srnrtkmh/RoomSeeker/README.md

# RoomSeeker
Autonomous robot project in my room
