srnrtkmh/RoomSeeker/HardwareElectric/01_RoomSeeker_SystemConfiguration_210212.pdf

1 | 2 | 3 | 4 | 5 | 6 | 7 | 8 | 9 | 10 | 11 | 12 | 13 | 14 | 15 | 16 | 17 | 18 | 19 | 20 | 21 | 22 | 23 | 24 | 25 | 26 | 27 | 28 | 29 | 30 | 31 | 32
A | A
B | B
C | C
Vcc (3.3V) | USB cable | USB cable
D | Echo | D
| | | | | | Trig
E | Gnd | E

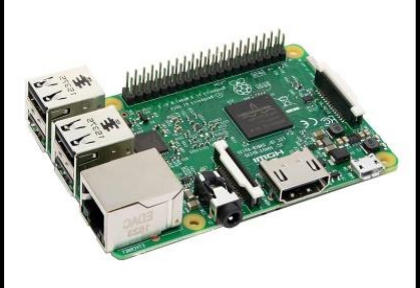
[picture p1: figure]

F | F
G | G
H | H
Vcc (5V)
I | Trig | I
| | | | | | Echo

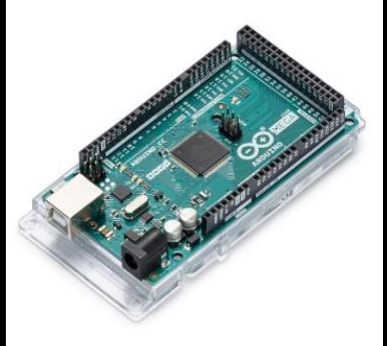
[picture p2: figure]

J | Gnd | USB cable | J
K | K
L | L
M | M
N | Vcc (5V) | N
| | | | | | Gnd
O | Out | O
P | P
Q | Q
R | R
S | Gnd | S
Vcc (5V)
T | Dat | T
| | | | | | Sel
U | Cmd | U
| | | | | | Clk
V | V
W | W
X | X
Y | Y
Z | Update Information | Z
１．'21/2/13 初版完成
２．
３．
４．
Copyright © Kyohei UMEMOTO. All Right Reserved.

## System Configuration of RoomSeeker

USB cable

Designed By | Title: System Configuration of RoomSeeker Kyohei UMEMOTO
Checked By | Doc No. | 20I001 | - | 1 Kyohei UMEMOTO

RPLiDAR A1M8

Arduino
Nano

L298N
Motor
Control
board

Ultra sonic sensor
HC-SR04

IMU unit
MPU-9250

ArduinoMega
with
RoomSeeker
Shield

Ir obstacle sensor
HC-SR04

×4

×12

×1

Wireless PS2
controller

Raspberry Pi 3
Model B

Arduino
Nano

L298N
Motor
Control
board
