srnrtkmh/RoomSeeker/Level2_Remote/room_seeker_description/meshes/sensors/RP-lidar-A1.stl

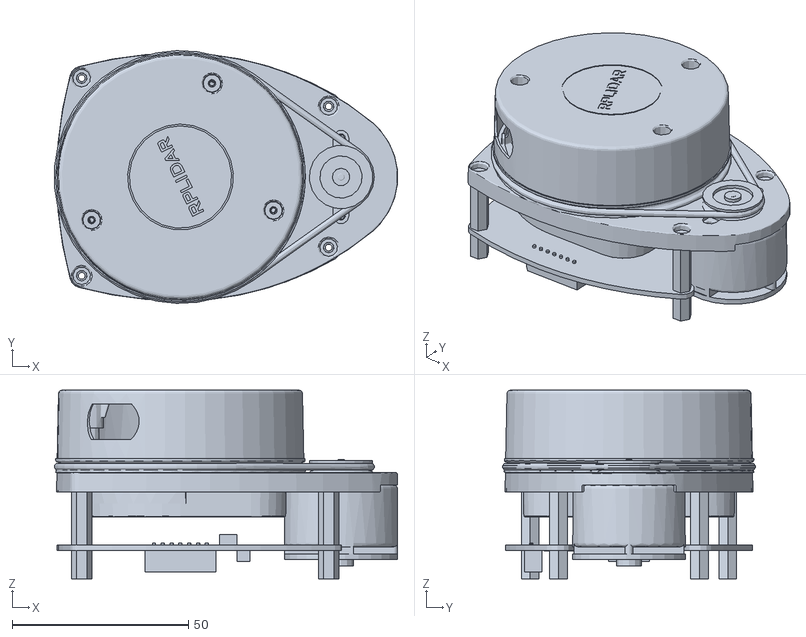
[picture p3: CAD file, 2021-02-12]
Level2_Remote/room_seeker_description/meshes/sensors/RP-lidar-A1.stl
97.2 x 71.6 x 53.5
