srnrtkmh/RoomSeeker/Level2_Remote/room_seeker_description/meshes/wheels/LeftMecanumWheel.stl

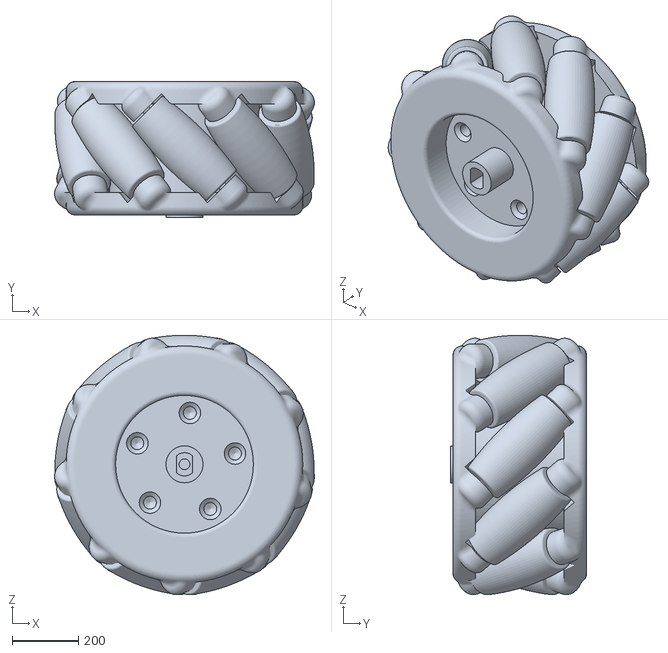
[picture p4: CAD file, 2021-01-31]
Level2_Remote/room_seeker_description/meshes/wheels/LeftMecanumWheel.stl
785.8 x 410.8 x 784.3
