srnrtkmh/RoomSeeker/Level2_Remote/room_seeker_description/meshes/sensors/lds.stl

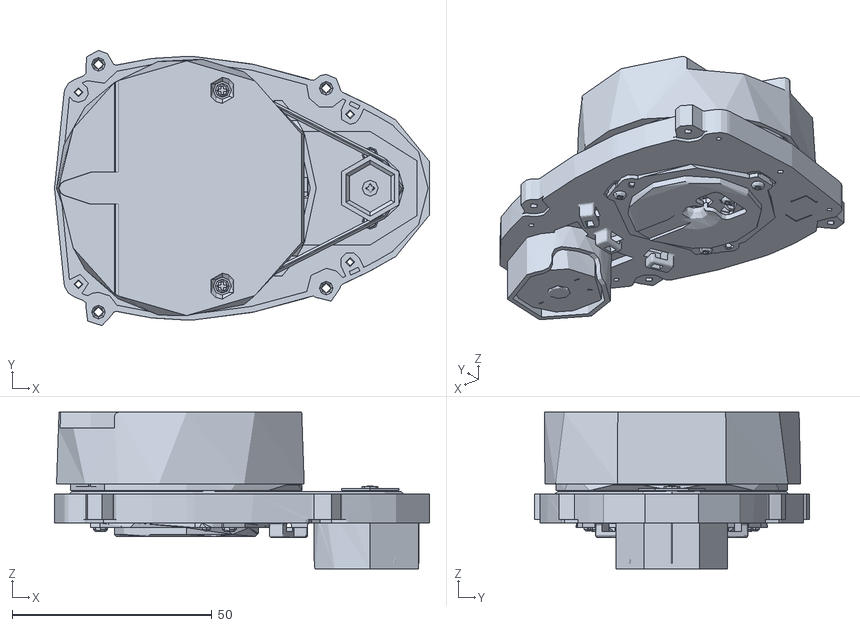
[picture p5: CAD file, 2021-01-28]
Level2_Remote/room_seeker_description/meshes/sensors/lds.stl
93.8 x 68.9 x 39.2
