srnrtkmh/RoomSeeker/Level2_Remote/room_seeker_description/meshes/wheels/RightMecanumWheel.stl

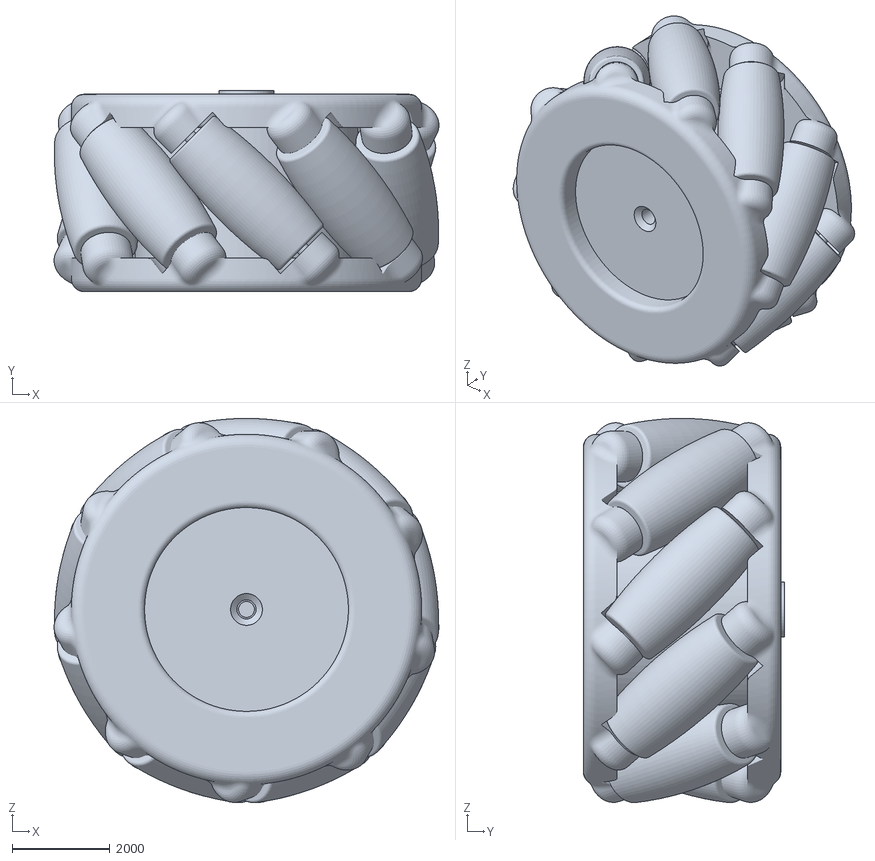
[picture p6: CAD file, 2021-01-31]
Level2_Remote/room_seeker_description/meshes/wheels/RightMecanumWheel.stl
7858.0 x 4108.0 x 7842.6
