srnrtkmh/RoomSeeker/HardwareElectric/02_RoomSeeker_PowerSupplyDIagram_210212.pdf

## Power supply diagram

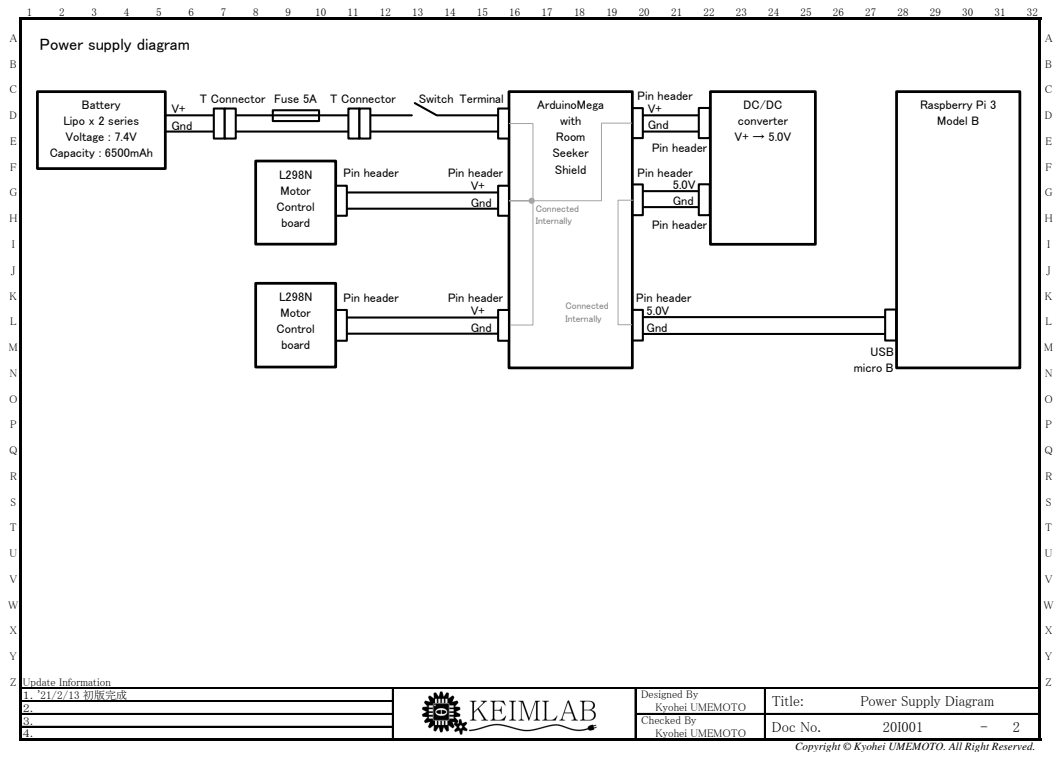
[picture p7: page 1]
Update Information; １．'21/2/13 初版完成 ２． ３． ４．; Checked By; Doc No.; 2 Kyohei UMEMOTO; Designed By; Title:; Power Supply Diagram Kyohei UMEMOTO; 5.0V Gnd; Pin header; USB micro B; V+ Gnd; ArduinoMega with Room Seeker Shield; Raspberry Pi 3 Model B; Battery Lipo x 2 series Voltage : 7.4V Capacity : 6500mAh; T Connector Fuse 5A T Connector; Switch Terminal; L298N Motor Control board; Gnd; DC/DC converter V+ → 5.0V; Connected Internally

Copyright © Kyohei UMEMOTO. All Right Reserved.
