srnrtkmh/RoomSeeker/HardwareElectric/DCMotorController_rev1.pdf

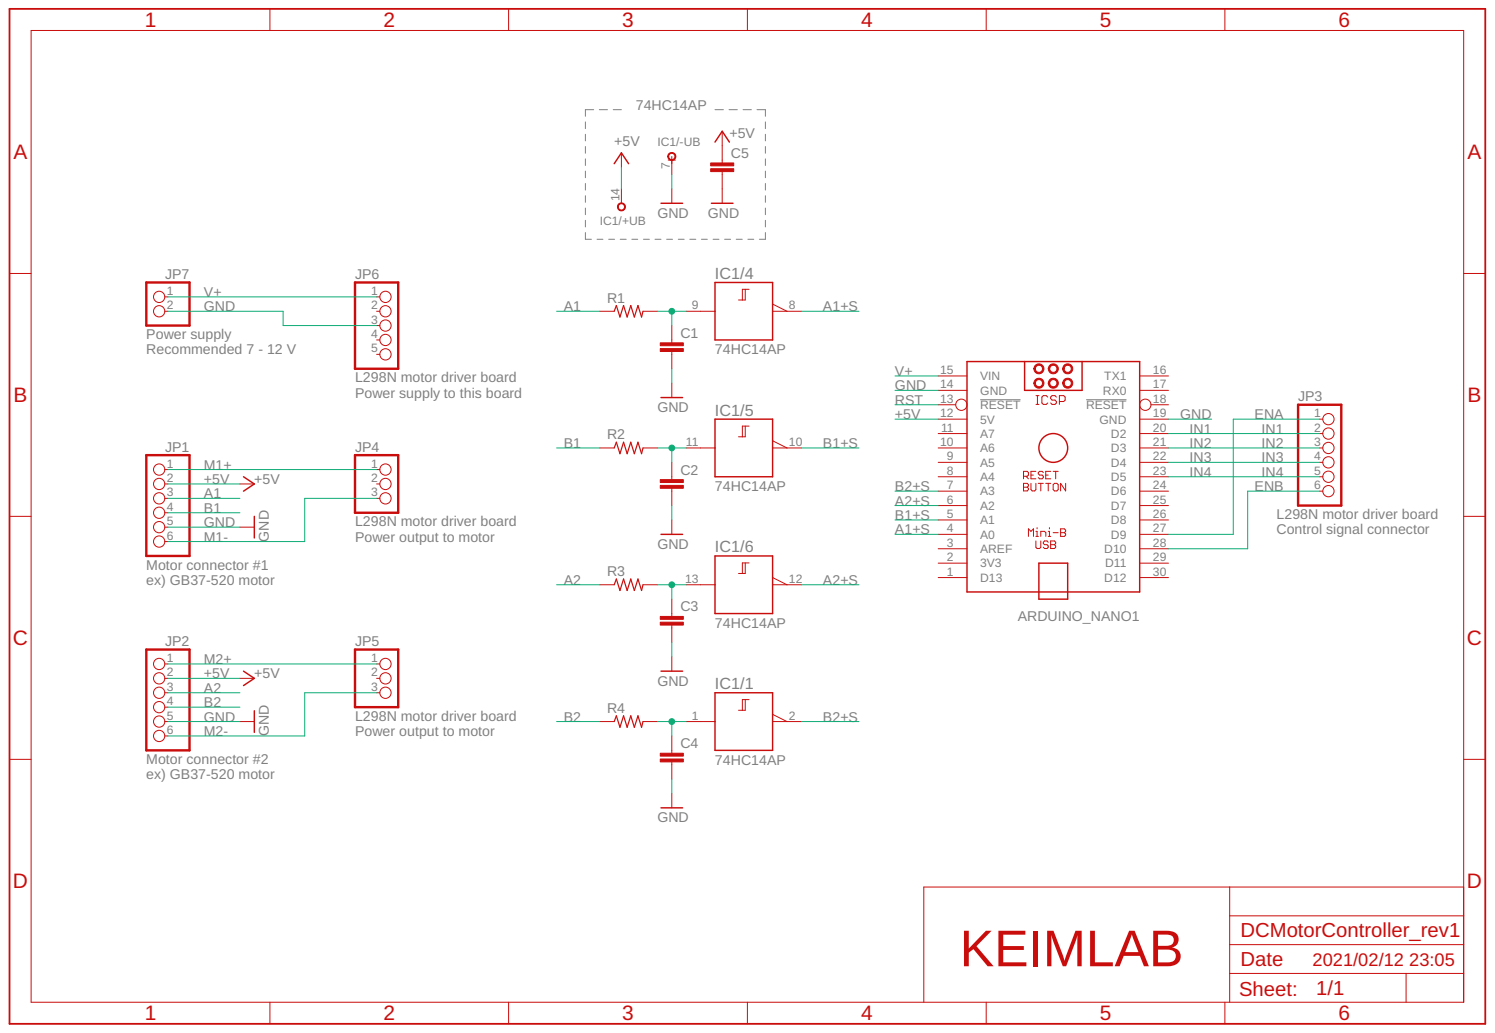
[picture p8: page 1]

L298N motor driver board
Power supply to this board

Control signal connector L298N motor driver board
Power output to motor
