srnrtkmh/RoomSeeker/HardwareElectric/RoomSeekerShield_rev4.pdf

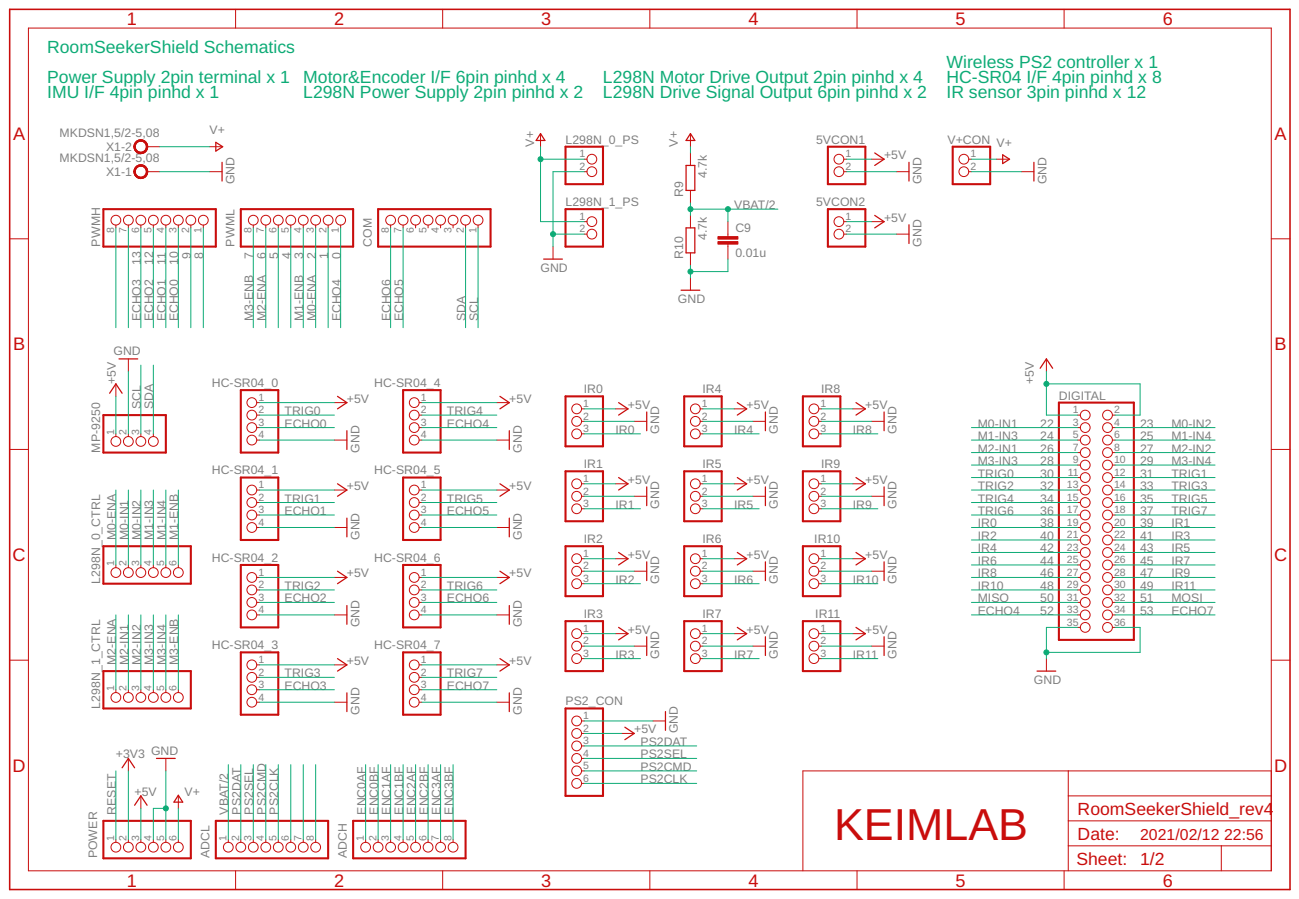
[picture p9: page 1]

L298N Motor Drive Output 2pin pinhd x 4
L298N Drive Signal Output 6pin pinhd x 2

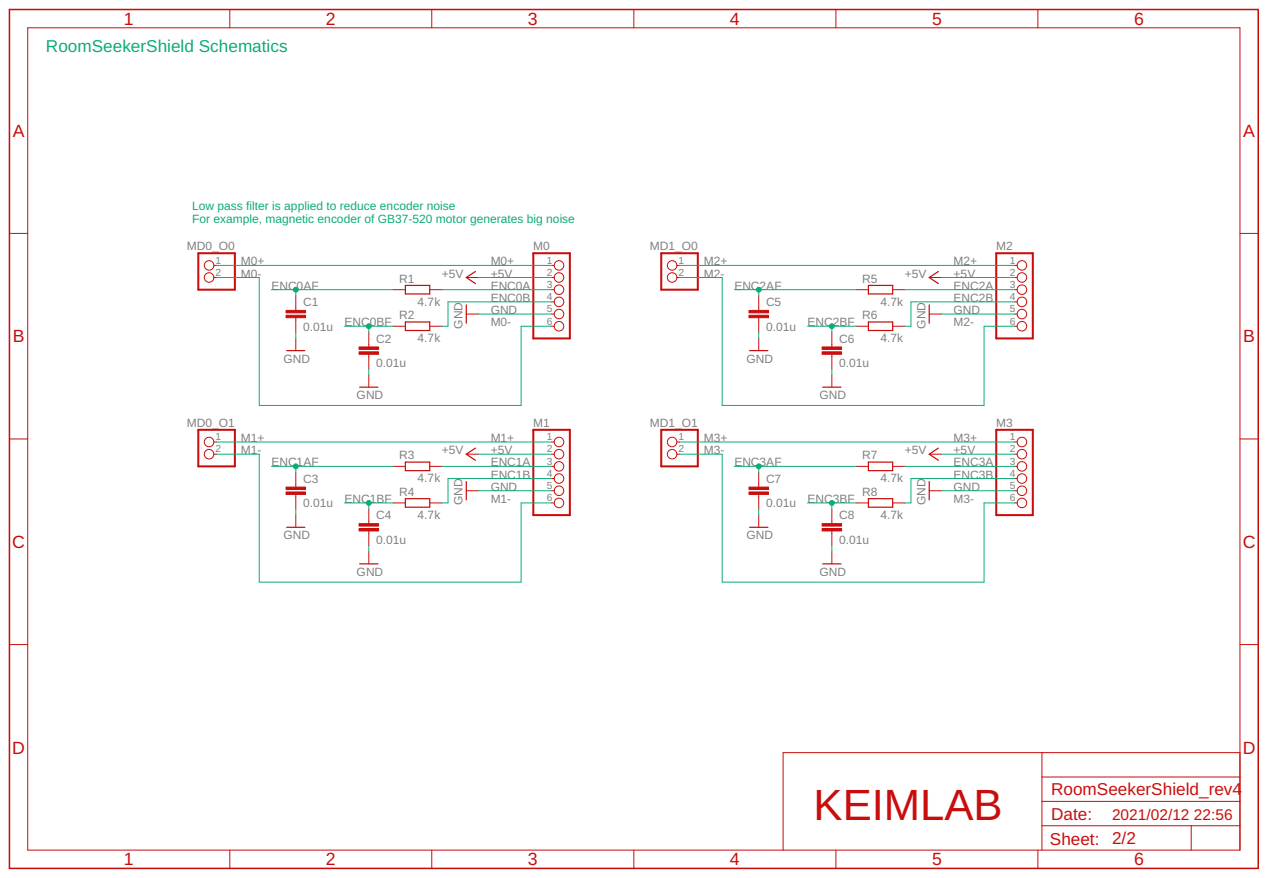
[picture p10: page 2]

Low pass filter is applied to reduce encoder noise For example, magnetic encoder of GB37-520 motor generates big noise
