srnrtkmh/RoomSeeker/Level2_Robot/room_seeker_core/scripts/room_seeker_core_v1.py

#!/usr/bin/env python
# coding: utf-8
#==================================================================================================#
#                                                                                                  #
# FILE : room_seeker_core_v1.py                                                                    #
# Memo : The core program for RoomSeeker                                                           #
#          * Control the all motors of mecanum wheels                                              #
#          * Calculate the odometry                                                                #
#          * Collect sensor data (IR sensor, Ultra sonic sensor, IMU, PS2 controller)              #
#                                                                                                  #
# Updated : 2021/01/16 : Startded this project based on "turtlebot3_core_v2.py"                    #
#           2021/01/18 : Added inverse kinematics program                                          #
#           2021/01/22 : Added sensor node communication program                                   #
#           2021/01/28 : Clean codes                                                               #
#           2021/01/31 : Added room_seeker msgs based on turtlebot3_msgs                           #
#           2021/02/06 : Send stop command if the robot don't receive command for a while          #
#           2021/02/11 : Added service calling function 'stop_motor' & 'start_motor' of rplidar    #
#                                                                                                  #
#                                                                       (C) 2021 Kyohei Umemoto    #
# How to execute :                                                                                 #
#     rosrun room_seeker_core room_seeker_core_v1.py                                               #
#                                                                                                  #
# Argument Discription :                                                                           #
#     none                                                                                         #
#                                                                                                  #
# I/O assign :                                                                                     #
# 01 : 3.3V                                       02 : 5.0V                                        #
# 03 : NC                                         04 : 5.0V                                        #
# 05 : NC                                         06 : GND                                         #
# 07 : NC                                         08 : NC                                          #
# 09 : NC                                         10 : NC                                          #
# 11 : NC                                         12 : NC                                          #
# 13 : NC                                         14 : NC                                          #
# 15 : NC                                         16 : NC                                          #
# 17 : NC                                         18 : NC                                          #
# 19 : NC                                         20 : NC                                          #
# 21 : NC                                         22 : NC                                          #
# 23 : NC                                         24 : NC                                          #
# 25 : GND                                        26 : NC                                          #
#                                                                                                  #
#==================================================================================================#

#==================================================================================================#
# Import Module                                                                                    #
#==================================================================================================#
import sys            # To use exit() and to get command line arguments
import time           # To use sleep function
import datetime       # To get datetime
import threading      # For multi thread programming
from math import *    # For mathematical operation
import serial         # To communicate with arduino through serial interface
import signal         # To receive signal
import numpy as np    # For matrix calculation

import rospy
import tf
import tf2_ros
from std_msgs.msg import String
from std_srvs.srv import Empty
from geometry_msgs.msg import Point, Pose, Quaternion, Twist, Vector3, TransformStamped
from nav_msgs.msg import Odometry
from sensor_msgs.msg import JointState, Imu, MagneticField, BatteryState
# from turtlebot3_msgs.msg import SensorState, VersionInfo
from room_seeker_msgs.msg import SensorState, VersionInfo

from room_seeker_l1 import *

#==================================================================================================#
# Global variables                                                                                 #
#==================================================================================================#
# Serial settings ---------------------------------------------------------------------------------#
serDevNameMEGA = "/dev/serial/by-path/platform-3f980000.usb-usb-0:1.4:1.0"        # Upper Right USB port : Arduino Mega
serBaudrateMEGA = 115200
serDevNameFM = "/dev/serial/by-path/platform-3f980000.usb-usb-0:1.2:1.0-port0"    # Upper Left USB port  : Front Motor Controller
#serDevNameFM = "/dev/serial/by-path/platform-3f980000.usb-usb-0:1.3.1:1.0-port0"  # Upper Left USB port  : Front Motor Controller
serBaudrateFM = 115200
serDevNameRM = "/dev/serial/by-path/platform-3f980000.usb-usb-0:1.3:1.0-port0"    # Lower Left USB port  : Rear Motor Controller
#serDevNameRM = "/dev/serial/by-path/platform-3f980000.usb-usb-0:1.3.2:1.0-port0"  # Lower Left USB port  : Rear Motor Controller
serBaudrateRM = 115200

# Data file settings ------------------------------------------------------------------------------#
preffix = "RoomSeekerData" # ファイル名プレフィックス
suffix = ""                         # ファイル名サフィックス

# ROS publish variables ---------------------------------------------------------------------------#
## Message variables
odom = Odometry()
#br = tf.TransformBroadcaster()
br = tf2_ros.TransformBroadcaster()
joint_states = JointState()
imu_msg = Imu()
mag_msg = MagneticField()
battery_state_msg = BatteryState()
battery_state = 0
sensor_state_msg = SensorState()
version_info_msg = VersionInfo()

## Frame ID
odom_header_frame_id = "odom"
odom_child_frame_id = "base_footprint"
joint_state_header_frame_id = "base_link"
imu_frame_id = "imu_link"
mag_frame_id = "mag_link"

## The others
BAT_CAPA    = 6.5
MIN_VOLT    = 6.8
MAX_VOLT    = 8.4
HARDWARE_VER = "0.0.0"
SOFTWARE_VER = "0.0.0"
FIRMWARE_VER = "0.0.0"
pub10cnt = 0

#==================================================================================================#
# 
#==================================================================================================#
def start_rplidar_motor():
  rospy.wait_for_service('start_motor')
  try:
    service_call = rospy.ServiceProxy('start_motor', Empty)
    service_call()
    print('called start_motor')
  except rospy.ServiceException, e:
    print ("Service call failed: %s" % e)

#==================================================================================================#
# twistCallBack                                                                                    #
#==================================================================================================#
def twistCallBack(twist):
  arduino.dx_cmd[0] = twist.linear.x
  arduino.dx_cmd[1] = twist.linear.y
  arduino.dx_cmd[2] = twist.angular.z
  if arduino.control_on == 0:
    arduino.control_on = 1
    start_rplidar_motor()
  arduino.no_input_from_twist = 0
  arduino.no_input_from_twist_cnt = 0
  # rospy.loginfo("x:%f, y:%f, z:%f, a:%f, b:%f, c:%f", twist.linear.x, twist.linear.y, twist.linear.z, twist.angular.x, twist.angular.y, twist.angular.z)

#==================================================================================================#
# Publish msgs (IMU data: angular velocity, linear acceleration, orientation)                      #
#   Future Works                                                                                   #
#==================================================================================================#
def publishImuMsg():
  imu_msg.header.stamp          = rospy.Time.now()
  imu_msg.header.frame_id       = imu_frame_id
  imu_msg.orientation.x         = arduino.mx - arduino.mx_offset
  imu_msg.orientation.y         = arduino.my - arduino.my_offset
  imu_msg.orientation.z         = arduino.mz - arduino.mz_offset
  imu_msg.orientation.w         = sqrt(arduino.mx**2 + arduino.my**2 + arduino.mz**2)
  imu_msg.angular_velocity.x    = arduino.gx
  imu_msg.angular_velocity.y    = arduino.gy
  imu_msg.angular_velocity.z    = arduino.gz
  imu_msg.linear_acceleration.x = arduino.ax
  imu_msg.linear_acceleration.y = arduino.ay
  imu_msg.linear_acceleration.z = arduino.az
  imu_pub.publish(imu_msg);

#==================================================================================================#
# Publish msgs (Magnetic data)                                                                     #
#==================================================================================================#
def publishMagMsg():
  mag_msg.header.stamp    = rospy.Time.now()
  mag_msg.header.frame_id = mag_frame_id;
  mag_msg.magnetic_field.x = arduino.mx;
  mag_msg.magnetic_field.y = arduino.my;
  mag_msg.magnetic_field.z = arduino.mz;
  mag_pub.publish(mag_msg);

#==================================================================================================#
# Publish msgs (sensor_state: bumpers, cliffs, buttons, encoders, battery)                         #
#==================================================================================================#
def publishSensorStateMsg():
  sensor_state_msg.header.stamp = rospy.Time.now()
  sensor_state_msg.battery = arduino.bat_vol
  sensor_state_msg.left_encoder = arduino.cnt_now[0]  
  sensor_state_msg.right_encoder = arduino.cnt_now[1]
  sensor_state_msg.bumper = 0                         # ToDo
  sensor_state_msg.cliff = 0.0;                       # ToDo
  # sensor_state_msg.sonar = sensors.getSonarData();    # ToDo
  sensor_state_msg.illumination = 0.0                 # ToDo
  sensor_state_msg.led = 0                            # ToDo
  sensor_state_msg.button = 0                         # ToDo
  sensor_state_msg.torque = False                     # ToDo
  sensor_state_pub.publish(sensor_state_msg)          # ToDo

#==================================================================================================#
# Publish msgs (version info)                                                                      #
#==================================================================================================#
def publishVersionInfoMsg():
  version_info_msg.hardware = HARDWARE_VER
  version_info_msg.software = SOFTWARE_VER
  version_info_msg.firmware = FIRMWARE_VER
  version_info_pub.publish(version_info_msg)

#==================================================================================================#
# Publish msgs (battery_state)                                                                     #
#==================================================================================================#
def publishBatteryStateMsg():
  battery_state_msg.header.stamp = rospy.Time.now()
  battery_state_msg.design_capacity = BAT_CAPA
  battery_state_msg.voltage = arduino.bat_vol
  battery_state_msg.percentage = (battery_state_msg.voltage - MIN_VOLT) / (MAX_VOLT - MIN_VOLT)
  if battery_state == 0:
    battery_state_msg.present = False
  else:
    battery_state_msg.present = true  
  battery_state_pub.publish(battery_state_msg);

#==================================================================================================#
# Publish msgs (odometry, joint states, tf)                                                        #
#==================================================================================================#
def publishDriveInformation():
  # odometry
  odom.header.stamp = rospy.Time.now()
  odom.header.frame_id = odom_header_frame_id
  odom.child_frame_id  = odom_child_frame_id
  odom.pose.pose.position.x = arduino.x_res[0]
  odom.pose.pose.position.y = arduino.x_res[1]
  odom.pose.pose.position.z = 0.0
  q_tmp = tf.transformations.quaternion_from_euler(0.0, 0.0, arduino.x_res[2])
  odom.pose.pose.orientation.x = q_tmp[0]
  odom.pose.pose.orientation.y = q_tmp[1]
  odom.pose.pose.orientation.z = q_tmp[2]
  odom.pose.pose.orientation.w = q_tmp[3]
  odom.twist.twist.linear.x  = arduino.dx_res[0]
  odom.twist.twist.linear.y  = arduino.dx_res[1]
  odom.twist.twist.linear.z  = 0.0
  odom.twist.twist.angular.z = arduino.dx_res[2]
  odom_pub.publish(odom)

  # odometry tf
  #br.sendTransform((arduino.x_res[0], arduino.x_res[1], 0.0),
  #                 tf.transformations.quaternion_from_euler(0.0, 0.0, arduino.x_res[2]),
  #                 rospy.Time.now(),
  #                 odom.child_frame_id,
  #                 odom.header.frame_id)
  #                 # "world")
  
  t = TransformStamped()
  t.header.stamp = rospy.Time.now()
  t.header.frame_id = odom.header.frame_id
  t.child_frame_id = odom.child_frame_id
  t.transform.translation.x = arduino.x_res[0]
  t.transform.translation.y = arduino.x_res[1]
  t.transform.translation.z = 0.0
  q = tf.transformations.quaternion_from_euler(0.0, 0.0, arduino.x_res[2])
  t.transform.rotation.x = q[0]
  t.transform.rotation.y = q[1]
  t.transform.rotation.z = q[2]
  t.transform.rotation.w = q[3]
  br.sendTransform(t)
  
  # joint states
  joint_states.header.stamp = rospy.Time.now();
  joint_states.position = arduino.cnt_now / 22.0 / 30.0
  joint_states.velocity = arduino.omega_res
  joint_states_pub.publish(joint_states)

#==================================================================================================#
# Initialize Joint State                                                                           #
#==================================================================================================#
def initJointStates():
  joint_states.header.frame_id = joint_state_header_frame_id
  joint_states.name            = ['front_right_wheel_joint', 'front_left_wheel_joint', 'rear_right_wheel_joint', 'rear_left_wheel_joint']
  joint_states.position        = [0.0, 0.0, 0.0, 0.0]
  joint_states.velocity        = [0.0, 0.0, 0.0, 0.0]
  joint_states.effort          = [0.0, 0.0, 0.0, 0.0]

#==================================================================================================#
# Descriminate the literal is integer or not                                                       #
#==================================================================================================#
def is_int(s):
  try:
    int(s)
    return True
  except ValueError:
    return False

#==================================================================================================#
# Signal Receive Function                                                                          #
#==================================================================================================#
def receive_signal(signum, stack):
  print "Received signal :", signum
  currentDate = datetime.datetime.today()  # today()メソッドで現在日付・時刻のdatetime型データの変数を取得
  log_file.write(str(currentDate) + " : Received signal " + str(signum) + ". End this process/\n")
  arduino.conMEGA.write("tttt")
  arduino.conFM.write("tttt")
  arduino.conRM.write("tttt")
  data_file.close()
  log_file.close()
  sys.exit(0)

#==================================================================================================#
# Keyboard input function                                                                          #
#==================================================================================================#
def key_input():
  print("key_input started.")
  while True:
    time.sleep(0.01)
    test = raw_input()
    
    if test == 'w':
      arduino.dx_cmd_x10[0] += 1000
    elif test == 'x':
      arduino.dx_cmd_x10[0] -= 1000
    elif test == 'a':
      arduino.dx_cmd_x10[1] += 1000
    elif test == 'd':
      arduino.dx_cmd_x10[1] -= 1000
    elif test == 's':
      arduino.dx_cmd_x10[0] = 0
      arduino.dx_cmd_x10[1] = 0
      arduino.dx_cmd_x10[2] = 0
    else:
      # arduino.conMEGA.write(test)
      print(test)

#==================================================================================================#
# Send start command to arduino via serial port                                                    #
#   Argument con : serial console object to send start command                                     #
#   Return       : None                                                                            #
#==================================================================================================#
def send_start(con):
  tmp_str = con.read(con.inWaiting())     # Read buffer to empty it
  time.sleep(0.2)                         # Wait a while to stabilize(?)
  con.write("s")                          # 1st : Send start command 's' to serial port
  log_file.write(str(currentDate) + " : Start command transmitted (1st try).\n")
  time.sleep(0.5)                         # 1st : Wait 0.5sec to receive callback
  tmp_str = con.read(con.inWaiting())     # 1st : Check if the callback is sent or not
  if len(tmp_str) <= 10:                  # 2nd : Re-send start command if don't get callback
    con.write("s")                        # 2nd : Send start command 's' to serial port
    log_file.write(str(currentDate) + " : Start command transmitted (2nd try). Previous tmp_str : " + tmp_str + "\n")
    time.sleep(0.5)                       # 2nd : Wait 0.5sec to receive callback
    tmp_str = con.read(con.inWaiting())   # 2nd : Check if the callback is sent or not
    if len(tmp_str) <= 10:                # 2nd : Re-send start command if don't get callback
      con.write("s")                      # 3rd : Send start command 's' to serial port
      log_file.write(str(currentDate) + " : Start command transmitted (3rd try). Previous tmp_str : " + tmp_str + "\n")
      time.sleep(0.5)                     # 3rd : Wait 0.5sec to receive callback (3rd)
      tmp_str = con.read(con.inWaiting()) # 3rd : Send start command 's' to serial port
      if len(tmp_str) <= 10:              # 3rd : Re-send start command if don't get callback
        print str(con.port) + " did not transmit call back : " + tmp_str
        con.write("t")                    # 3rd : Send stop command for make sure
        sys.exit(1)
  tmp_str = con.read(con.inWaiting())     # Empty the receive buffer
  log_file.write(str(currentDate) + " : Start command echo back received.\n")

#==================================================================================================#
# continue_control_ps2()                                                                          #
#   Argument : none                                                                                #
#   Return   : none                                                                                #
#==================================================================================================#
def continue_control_ps2():
  if arduino.control_on == 0:
    arduino.control_on = 1
    start_rplidar_motor()
  arduino.no_input_from_ps2 = 0
  arduino.no_input_from_ps2_cnt = 0

#==================================================================================================#
# stop_control()                                                                                   #
#==================================================================================================#
def stop_control():
  arduino.control_on = 0
  arduino.conFM.write("ttttt")
  arduino.conRM.write("ttttt")
  rospy.wait_for_service('stop_motor')
  try:
    service_call = rospy.ServiceProxy('stop_motor', Empty)
    service_call()
    print('called stop_motor')
  except rospy.ServiceException, e:
    print ("Service call failed: %s" % e)

#==================================================================================================#
# Main Function                                                                                    #
#==================================================================================================#
if __name__ == '__main__':
  # Initialize
  arduino = RoomSeekerLevel1()                  # Robot control variables (current)
  signal.signal(signal.SIGINT, receive_signal)  # Signal setting
  
  # Create the thread to get keyboard input
  th_key = threading.Thread(target=key_input)
  th_key.setDaemon(True)
  th_key.start()
  
  # Open log file
  currentDate = datetime.datetime.today() # Get current date
  log_file_name = unicode("/home/kyohei/catkin_ws/src/room_seeker/room_seeker_core/scripts/log/" + preffix + currentDate.strftime('%Y_%m_%d_%H_%M_%S') + suffix + ".log", encoding='shift-jis')
  log_file = open(log_file_name, 'w')
  log_file.write(str(currentDate) + " : Started to logging." + "\n")
  
  # Open data file
  strCsvName = unicode("/home/kyohei/catkin_ws/src/room_seeker/room_seeker_core/scripts/data/" + preffix + currentDate.strftime('%Y_%m_%d_%H_%M_%S') + suffix + ".csv", encoding='shift-jis')
  data_file = open(strCsvName, 'w')
  data_file.write("time,nMEGA,nFM,nRM,cnt_now[0],cnt_now[1],cnt_now[2],cnt_now[3]"
    + ",omega_res[0],omega_res[1],omega_res[2],omega_res[3]"
    + ",omega_cmd[0],omega_cmd[1],omega_cmd[2],omega_cmd[3]"
    + ",vout[0],vout[1],vout[2],vout[3]"
    + ",dx_res[0],dx_res[1],dx_res[2]"
    + ",dx_cmd[0],dx_cmd[1],dx_cmd[2]"
    + ",x_res[0],x_res[1],x_res[2],x_res_[2],int_gz_hpf"
    + ",ir_state,ax,ay,az,gx,gy,gz,gz_hpf,mx,my,mz,temp,bat_vol,ps2_button,ps2_analogRX,ps2_analogRY,ps2_analogLX,ps2_analogLY"
    + "\n")
  currentDate = datetime.datetime.today()
  log_file.write(str(currentDate) + " : New file opened successfully. File name = " + strCsvName + "\n")
  
  # ROS settings ----------------------------------------------------------------------------------#
  rospy.init_node('level1_node', anonymous=True)            # Initialize node
  rate = rospy.Rate(arduino.ros_rate)                       # Sampling time [Hz]

  # Publisher settings
  initJointStates()
  odom_pub = rospy.Publisher('odom', Odometry, queue_size=50)
  joint_states_pub = rospy.Publisher('joint_states', JointState, queue_size=50);
  sensor_state_pub = rospy.Publisher('sensor_state', SensorState, queue_size=50)
  version_info_pub = rospy.Publisher('firmware_version', VersionInfo, queue_size=50)
  imu_pub = rospy.Publisher('imu', Imu, queue_size=50)
  mag_pub = rospy.Publisher('magnetic_field', MagneticField, queue_size=50)
  battery_state_pub = rospy.Publisher('battery_state', BatteryState, queue_size=50)
  
  # Subscriber settings
  sub = rospy.Subscriber('cmd_vel', Twist, twistCallBack)
  currentDate = datetime.datetime.today()
  log_file.write(str(currentDate) + " : ROS Settings finished.\n")
  
  # Setup serial communication with ArduinoMEGA ---------------------------------------------------#
  try: # Set "rtscts" and "dsrdtr" to "True" if you communicate with Arduino Micro. if you use Arduino Nano, both is fine.
    arduino.conMEGA = serial.Serial(serDevNameMEGA, serBaudrateMEGA, timeout=0, rtscts=True, dsrdtr=True)
    time.sleep(0.5)
  except serial.SerialException as e:
    print "SerialException : " + str(e)
    sys.exit(1)
  currentDate = datetime.datetime.today()
  log_file.write(str(currentDate) + " : Serial port opened successfully. Port name = " + arduino.conMEGA.portstr + "\n")
  
  # Setup serial communication with ArduinoFM -----------------------------------------------------#
  try: # Set "rtscts" and "dsrdtr" to "True" if you communicate with Arduino Micro. if you use Arduino Nano, both is fine.
    arduino.conFM = serial.Serial(serDevNameFM, serBaudrateFM, timeout=0, rtscts=True, dsrdtr=True)
    time.sleep(0.5)
  except serial.SerialException as e:
    print "SerialException : " + str(e)
    sys.exit(1)
  currentDate = datetime.datetime.today()
  log_file.write(str(currentDate) + " : Serial port opened successfully. Port name = " + arduino.conFM.portstr + "\n")
  
  # Setup serial communication with ArduinoRM -----------------------------------------------------#
  try: # Set "rtscts" and "dsrdtr" to "True" if you communicate with Arduino Micro. if you use Arduino Nano, both is fine.
    arduino.conRM = serial.Serial(serDevNameRM, serBaudrateRM, timeout=0, rtscts=True, dsrdtr=True)
    time.sleep(0.5)
  except serial.SerialException as e:
    print "SerialException : " + str(e)
    sys.exit(1)
  currentDate = datetime.datetime.today()
  log_file.write(str(currentDate) + " : Serial port opened successfully. Port name = " + arduino.conRM.portstr + "\n")
  
  # Send start command to arduino controller
  send_start(arduino.conMEGA) # Send start command to arduino MEGA
  send_start(arduino.conFM)   # Send start command to arduino Front Motor
  send_start(arduino.conRM)   # Send start command to arduino Rear Motor
  stop_control()              # Stop control until input command
  
  # Start periodic process
  try:
    while True:
      start_date = datetime.datetime.today()

      # Sensing process ---------------------------------------------------------------------------#
      arduino.readMEGA()
      arduino.readFM()
      arduino.readRM()
      arduino.apply_filter()
      arduino.odometry_update_res()
      
      # Publish information
      publishDriveInformation()
      publishImuMsg()
      publishMagMsg()
      pub10cnt += 1
      if pub10cnt >= 10:
        pub10cnt = 0
        publishBatteryStateMsg()
        publishSensorStateMsg()
        publishVersionInfoMsg()
        log_file.flush()
      
      # Select control mode -----------------------------------------------------------------------#
      if((arduino.ps2_button & PSB_SELECT) != 0):
        print('PS2 mode reset')
        arduino.mode = MODE_TWIST
        arduino.dx_cmd[0] = 0
        arduino.dx_cmd[1] = 0
        arduino.dx_cmd[2] = 0
        arduino.no_input_from_ps2 = 1
        arduino.no_input_from_twist = 0
        arduino.no_input_from_twist_cnt = 0
        
      if((arduino.ps2_button & PSB_START) != 0):
        print('PS2 mode set')
        arduino.mode = MODE_PS2
        arduino.dx_cmd[0] = 0
        arduino.dx_cmd[1] = 0
        arduino.dx_cmd[2] = 0
        arduino.no_input_from_ps2 = 0
        arduino.no_input_from_ps2_cnt = 0
        arduino.no_input_from_twist = 1
      
      # Control process ---------------------------------------------------------------------------#
      if(arduino.mode == MODE_TWIST):
        if arduino.no_input_from_twist == 0:
          arduino.no_input_from_twist_cnt += 1
          if arduino.no_input_from_twist_cnt >= 3000:
            arduino.no_input_from_twist = 1
      
      if(arduino.mode == MODE_PS2):
        # X axis command
        if((arduino.ps2_button & PSB_PAD_UP) != 0):
          continue_control_ps2()
          if((arduino.ps2_button & PSB_CROSS) != 0):
            if((arduino.ps2_button & PSB_SQUARE) != 0):
              arduino.dx_cmd[0] = 0.3
            else:
              arduino.dx_cmd[0] = 0.2
          else:
            arduino.dx_cmd[0] = 0.1
            
        elif((arduino.ps2_button & PSB_PAD_DOWN) != 0):
          continue_control_ps2()
          if((arduino.ps2_button & PSB_CROSS) != 0):
            if((arduino.ps2_button & PSB_SQUARE) != 0):
              arduino.dx_cmd[0] = -0.3
            else:
              arduino.dx_cmd[0] = -0.2
          else:
            arduino.dx_cmd[0] = -0.1
        else:
          arduino.dx_cmd[0] = 0
          
        # Y axis command
        if((arduino.ps2_button & PSB_PAD_LEFT) != 0):
          continue_control_ps2()
          if((arduino.ps2_button & PSB_CROSS) != 0):
            if((arduino.ps2_button & PSB_SQUARE) != 0):
              arduino.dx_cmd[1] = 0.3
            else:
              arduino.dx_cmd[1] = 0.2
          else:
            arduino.dx_cmd[1] = 0.1
            
        elif((arduino.ps2_button & PSB_PAD_RIGHT) != 0):
          continue_control_ps2()
          if((arduino.ps2_button & PSB_CROSS) != 0):
            if((arduino.ps2_button & PSB_SQUARE) != 0):
              arduino.dx_cmd[1] = -0.3
            else:
              arduino.dx_cmd[1] = -0.2
          else:
            arduino.dx_cmd[1] = -0.1
        else:
          arduino.dx_cmd[1] = 0
      
        # Rotation command
        if((arduino.ps2_button & PSB_L1) != 0):
          continue_control_ps2()
          if((arduino.ps2_button & PSB_CROSS) != 0):
            if((arduino.ps2_button & PSB_SQUARE) != 0):
              arduino.dx_cmd[2] = 135.0 / 180.0 * 3.14
            else:
              arduino.dx_cmd[2] = 90.0 / 180.0 * 3.14
          else:
            arduino.dx_cmd[2] = 45.0 / 180.0 * 3.14
            
        elif((arduino.ps2_button & PSB_R1) != 0):
          continue_control_ps2()
          if((arduino.ps2_button & PSB_CROSS) != 0):
            if((arduino.ps2_button & PSB_SQUARE) != 0):
              arduino.dx_cmd[2] = -135.0 / 180.0 * 3.14
            else:
              arduino.dx_cmd[2] = -90.0 / 180.0 * 3.14
          else:
            arduino.dx_cmd[2] = -45.0 / 180.0 * 3.14
        else:
          arduino.dx_cmd[2] = 0
        
        # PS2 no input judge
        if arduino.no_input_from_ps2 == 0:
          arduino.no_input_from_ps2_cnt += 1
          if arduino.no_input_from_ps2_cnt >= 3000:
            arduino.no_input_from_ps2 = 1
      
      if arduino.control_on == 1:
        if arduino.no_input_from_ps2 == 1 and arduino.no_input_from_twist == 1:
          stop_control()
      
      arduino.rate_limit_work()
      arduino.inv_kine()
      if arduino.control_on == 1: arduino.command_motor_node()
      else:                       arduino.conFM.write("t")
      
      # Data output process -----------------------------------------------------------------------#
      if arduino.control_on == 1:
        currentDate = datetime.datetime.today()
        data_file.write(currentDate.strftime("%Y/%m/%d %H:%M:%S") + ".%03d" % (currentDate.microsecond // 1000)
          + ',' + str(arduino.sample_num_node_MEGA) + ',' + str(arduino.sample_num_node_FM) + ',' + str(arduino.sample_num_node_RM)
          + ',' + str(arduino.cnt_now[0]) + ',' + str(arduino.cnt_now[1]) + ',' + str(arduino.cnt_now[2]) + ',' + str(arduino.cnt_now[3])
          + ',' + str(arduino.omega_res[0]) + ',' + str(arduino.omega_res[1]) + ',' + str(arduino.omega_res[2]) + ',' + str(arduino.omega_res[3])
          + ',' + str(arduino.omega_cmd[0]) + ',' + str(arduino.omega_cmd[1]) + ',' + str(arduino.omega_cmd[2]) + ',' + str(arduino.omega_cmd[3])
          + ',' + str(arduino.vout[0]) + ',' + str(arduino.vout[1]) + ',' + str(arduino.vout[2]) + ',' + str(arduino.vout[3])
          + ',' + str(arduino.dx_res[0]) + ',' + str(arduino.dx_res[1]) + ',' + str(arduino.dx_res[2])
          + ',' + str(arduino.dx_cmd[0]) + ',' + str(arduino.dx_cmd[1]) + ',' + str(arduino.dx_cmd[2])
          + ',' + str(arduino.x_res[0]) + ',' + str(arduino.x_res[1]) + ',' + str(arduino.x_res[2]) + ',' + str(arduino.x_res_[2]) + ',' + str(arduino.int_gz_hpf)
          + ',' + bin(arduino.ir_hex) + ',' + str(arduino.ax) + ',' + str(arduino.ay) + ',' + str(arduino.az)
          + ',' + str(arduino.gx) + ',' + str(arduino.gy) + ',' + str(arduino.gz) + ',' + str(arduino.gz_hpf)
          + ',' + str(arduino.mx) + ',' + str(arduino.my) + ',' + str(arduino.mz) + ',' + str(arduino.temp)
          + ',' + str(arduino.bat_vol) + ',' + str(arduino.ps2_button) + ',' + str(arduino.ps2_analogRX) + ',' + str(arduino.ps2_analogRY) + ',' + str(arduino.ps2_analogLX) + ',' + str(arduino.ps2_analogLY)
          + '\n')
          
      # For debug information ---------------------------------------------------------------------#
      if arduino.control_on == 1:
        # arduino.print_sensor()
        # arduino.print_wrk()
        # arduino.print_state()
        # arduino.print_odom()
        stop_date = datetime.datetime.today()
        print((stop_date - start_date).microseconds)

      
      rate.sleep()
  
  except KeyboardInterrupt:
    receive_signal();
