srnrtkmh/RoomSeeker/(commit log)

2020-08-02 Added identification program of motor friction
2020-08-02 Level 1 Pin assign changed as not use timer0 to control motor. timer 0 is usede by arduino system for delay(), micros(), millis() ... etc
2020-08-08 Added us sensor detection to get the distance in front of the robot
2020-08-16 Auto running program added. simply avoid obstacle.
    [acceleration.cpp, acceleration.h, rotary_encoders.cpp, rotary_encoders.h]
2020-08-16 us_sensor_3 is added to move us sensor servo smoothly
2021-01-03 Added rate limit.
    [MotorControl_with_Lidar2020_10_31_22_16_16.csv, MotorControl_with_Lidar2020_10_31_22_25_33.csv, MotorControl_with_Lidar2020_10_31_22_26_00.csv, MotorControl_with_Lidar2020_10_31_22_29_24.csv, MotorControl_with_Lidar2020_10_31_22_32_08.csv, MotorControl_with_Lidar2020_10_31_22_41_25.csv, MotorControl_with_Lidar2020_10_31_22_46_13.csv, MotorControl_with_Lidar2020_10_31_22_46_38.csv]
2021-01-03 Added imu, battery check. Fixed PS2 controller and command confliction.
    [PS2X_lib.cpp, command.cpp, command.h, control_all.ino, i2c_basics.cpp, i2c_basics.h, mpu9250.cpp, mpu9250.h]
2021-01-17 Added motor control node program
2021-01-18 Added inverse kinematics to level 2 controller
2021-01-22 Added sensor node reading & command from PS2 controller
2021-01-28 bug fixes
    [common_properties.xacro, lds.stl, left_tire.stl, magnetometer_gui2021_01_23_15_32_52.csv, magnetometer_gui2021_01_23_15_35_01.csv, magnetometer_gui2021_01_23_15_35_52.csv, magnetometer_gui2021_01_23_15_38_02.csv, magnetometer_gui2021_01_23_15_52_52.csv]
2021-01-29 Cleaned no-needed files
    [MotorControl_with_Lidar2020_10_31_22_16_16.csv, MotorControl_with_Lidar2020_10_31_22_25_33.csv, MotorControl_with_Lidar2020_10_31_22_26_00.csv, MotorControl_with_Lidar2020_10_31_22_29_24.csv, MotorControl_with_Lidar2020_10_31_22_32_08.csv, MotorControl_with_Lidar2020_10_31_22_41_25.csv, MotorControl_with_Lidar2020_10_31_22_46_13.csv, MotorControl_with_Lidar2020_10_31_22_46_38.csv]
2021-01-31 Updated URDR for room_seeker_remote and added stl of robot model
    [LeftMecanumWheel.stl, RightMecanumWheel.stl, room_seeker.urdf.xacro]
2021-02-06 Added stop command after some no input time and small bug fixes
    [room_seeker_core_v1.py, room_seeker_l1.py]
2021-02-11 Added room_seeker_description, room_seeker_slam, room_seeker_navigation pakcage. room_seeker_navigation is now developing.
    [LeftMecanumWheel.stl, RightMecanumWheel.stl, common_properties.xacro, lds.stl, left_tire.stl, right_tire.stl, room_seeker.gazebo.xacro, room_seeker.urdf.xacro]
2021-02-11 Revised directory tree
    [LeftMecanumWheel.stl, RightMecanumWheel.stl, common_properties.xacro, lds.stl, magnetometer_gui2021_01_23_15_32_52.csv, magnetometer_gui2021_01_23_15_35_01.csv, magnetometer_gui2021_01_23_15_35_52.csv, magnetometer_gui2021_01_23_15_38_02.csv]
2021-02-12 Bug fixes. Added hardware schematics of MotorNode & SensorNode
    [RP-lidar-A1.stl, room_seeker.urdf.xacro]
